yyy257/sisp51/sisp51.pdf

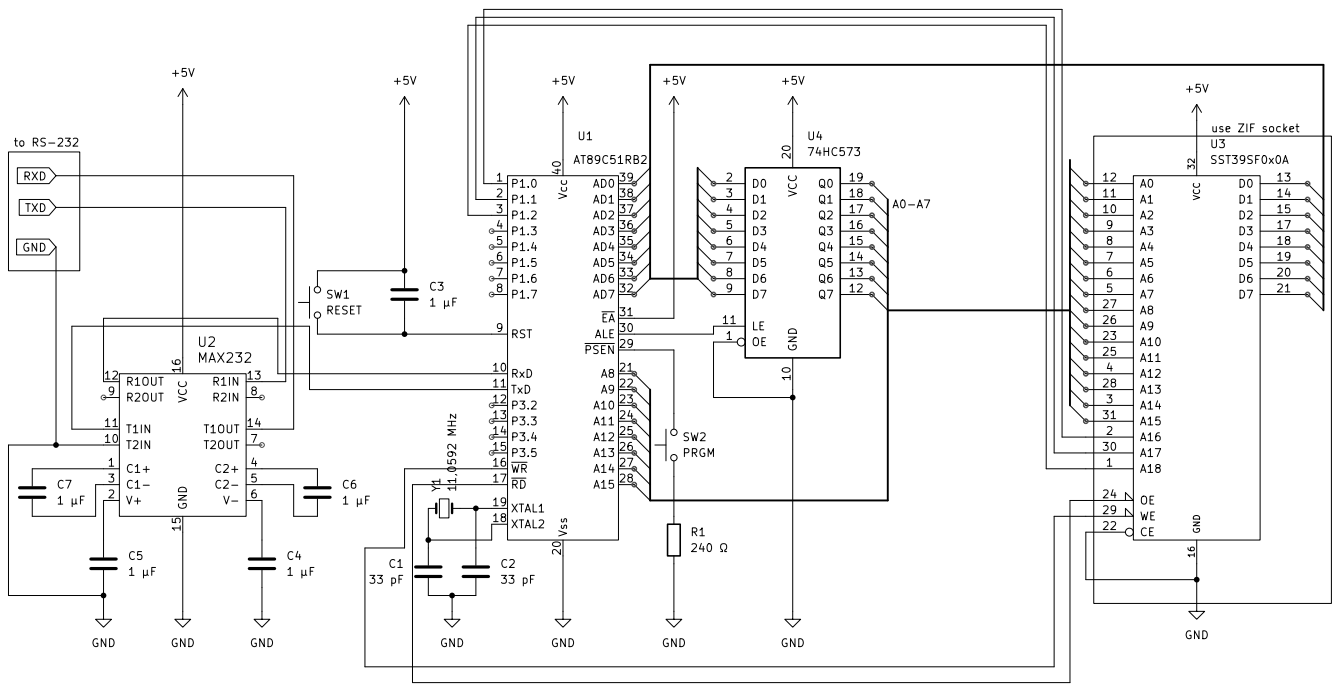
[picture p1: page 1]
