yyy257/sisp51/sisp51_kicad/sisp51.kicad_sch

## KiCad design sisp51_kicad/sisp51.kicad_sch (2024-06-06)

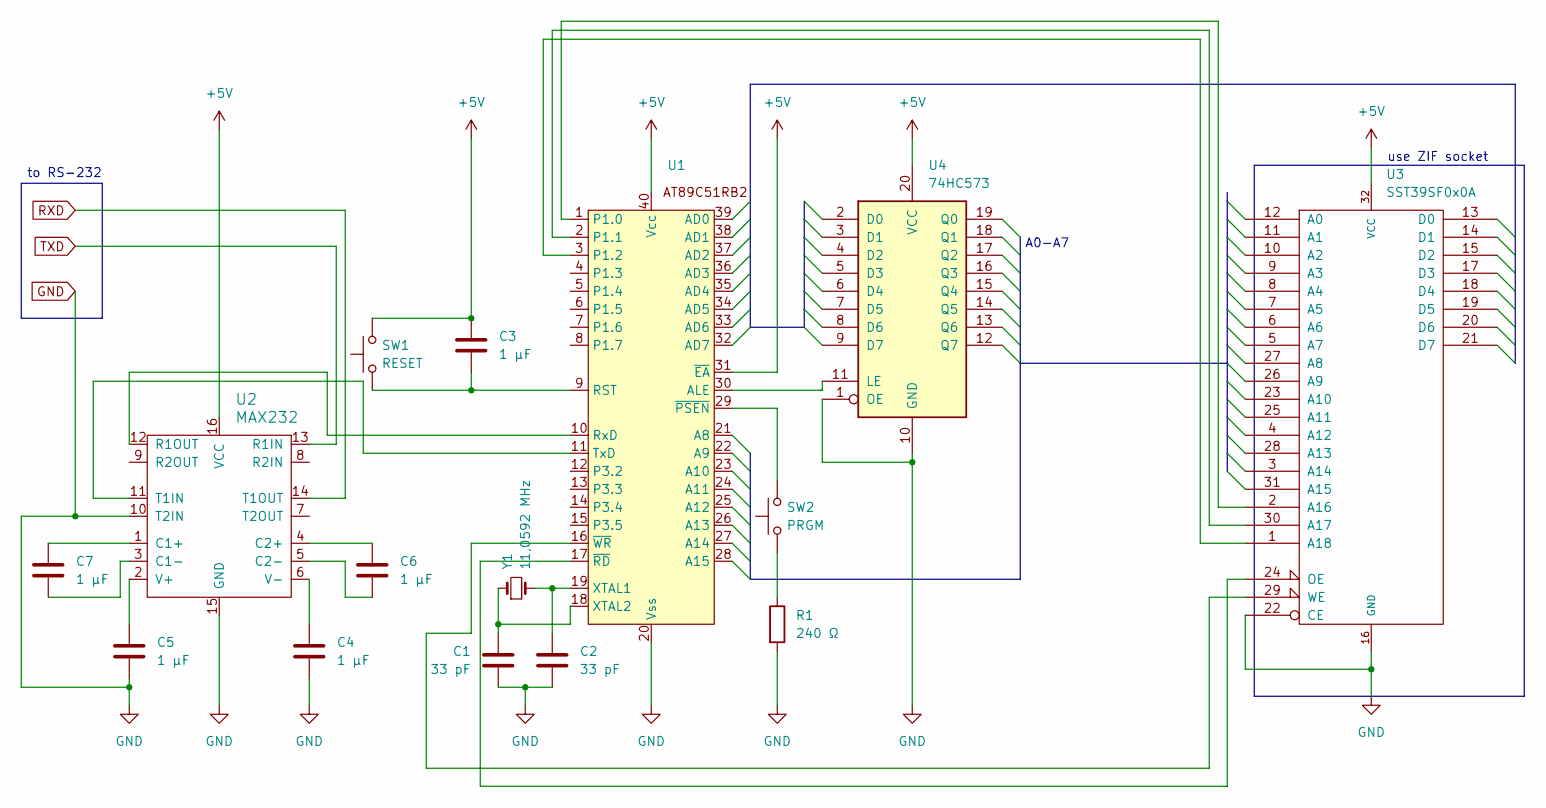
[picture p2: schematic sisp51.kicad_sch]

Parts:
C1, C2: 33 pF
C3, C4, C5, C6, C7: 1 µF
R1: 240 Ω
SW1: RESET
SW2: PRGM
U1: (no value)
U2: MAX232
U3: SST39SF0x0A
U4: 74HC573
Y1: 11,0592 MHz

Connections:
+5V: C3.1, SW1.2, U1.31 (~EA), U1.40 (Vcc), U2.16 (VCC), U3.32 (VCC), U4.20 (VCC)
GND: C1.2, C2.2, C4.2, C5.2, R1.2, U1.20 (Vss), U2.10 (T2IN), U2.15 (GND), U3.16 (GND), U3.22 (CE), U4.1 (OE), U4.10 (GND)
unnamed: C1.1, U1.18 (XTAL2), Y1.1
unnamed: C2.1, U1.19 (XTAL1), Y1.2
unnamed: C3.2, SW1.1, U1.9 (RST)
unnamed: C4.1, U2.6 (V-)
unnamed: C5.1, U2.2 (V+)
unnamed: C6.1, U2.4 (C2+)
unnamed: C6.2, U2.5 (C2-)
unnamed: C7.1, U2.1 (C1+)
unnamed: C7.2, U2.3 (C1-)
unnamed: R1.1, SW2.1
unnamed: SW2.2, U1.29 (~PSEN)
unnamed: U1.1 (P1.0), U3.2 (A16)
unnamed: U1.2 (P1.1), U3.30 (A17)
unnamed: U1.3 (P1.2), U3.1 (A18)
unnamed: U1.10 (P3.0), U2.12 (R1OUT)
unnamed: U1.11 (P3.1), U2.11 (T1IN)
unnamed: U1.16 (P3.6), U3.29 (WE)
unnamed: U1.17 (P3.7), U3.24 (OE)
unnamed: U1.30 (ALE), U4.11 (LE)
RXD: U2.14 (T1OUT)
TXD: U2.13 (R1IN)

Notes on the sheet:
use ZIF socket
A0-A7
to RS-232
